kazunobumiyatani/egg52/egg52/ergo50-Edge.Cuts.dxf

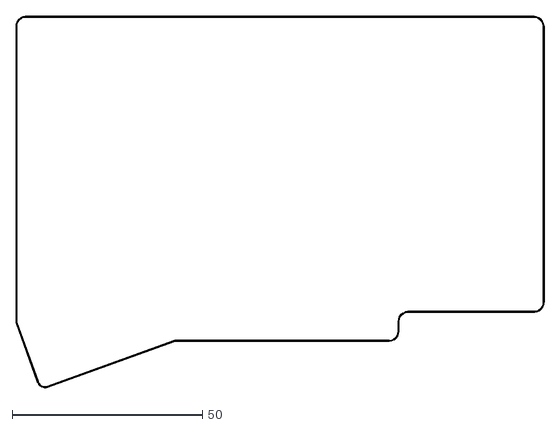
[picture p1: CAD file, 2019-05-01]
egg52/ergo50-Edge.Cuts.dxf
138.6 x 97.5
