kazunobumiyatani/egg52/egg52/ergo50-F.CrtYd.dxf

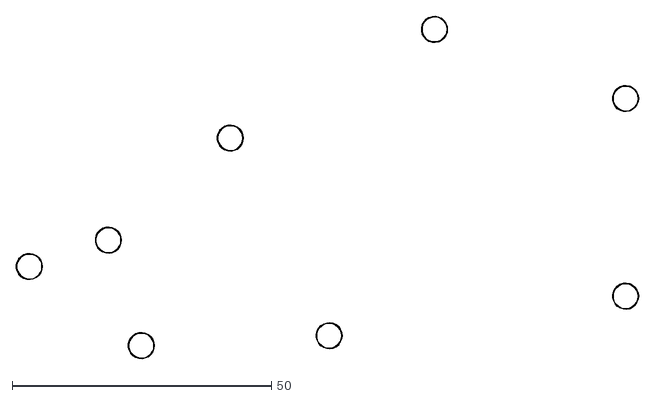
[picture p2: CAD file, 2019-05-01]
egg52/ergo50-F.CrtYd.dxf
119.9 x 65.9
