kazunobumiyatani/egg52/egg52/ergo50-Dwgs.User.dxf

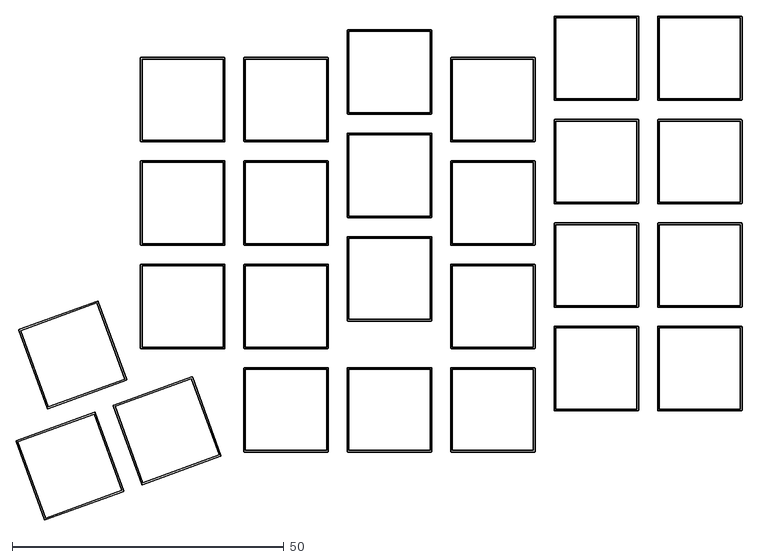
[picture p3: CAD file, 2019-05-01]
egg52/ergo50-Dwgs.User.dxf
133.7 x 92.8
