kazunobumiyatani/egg52/egg52/ergo50.sch

## KiCad design egg52/ergo50.sch (2019-05-01)

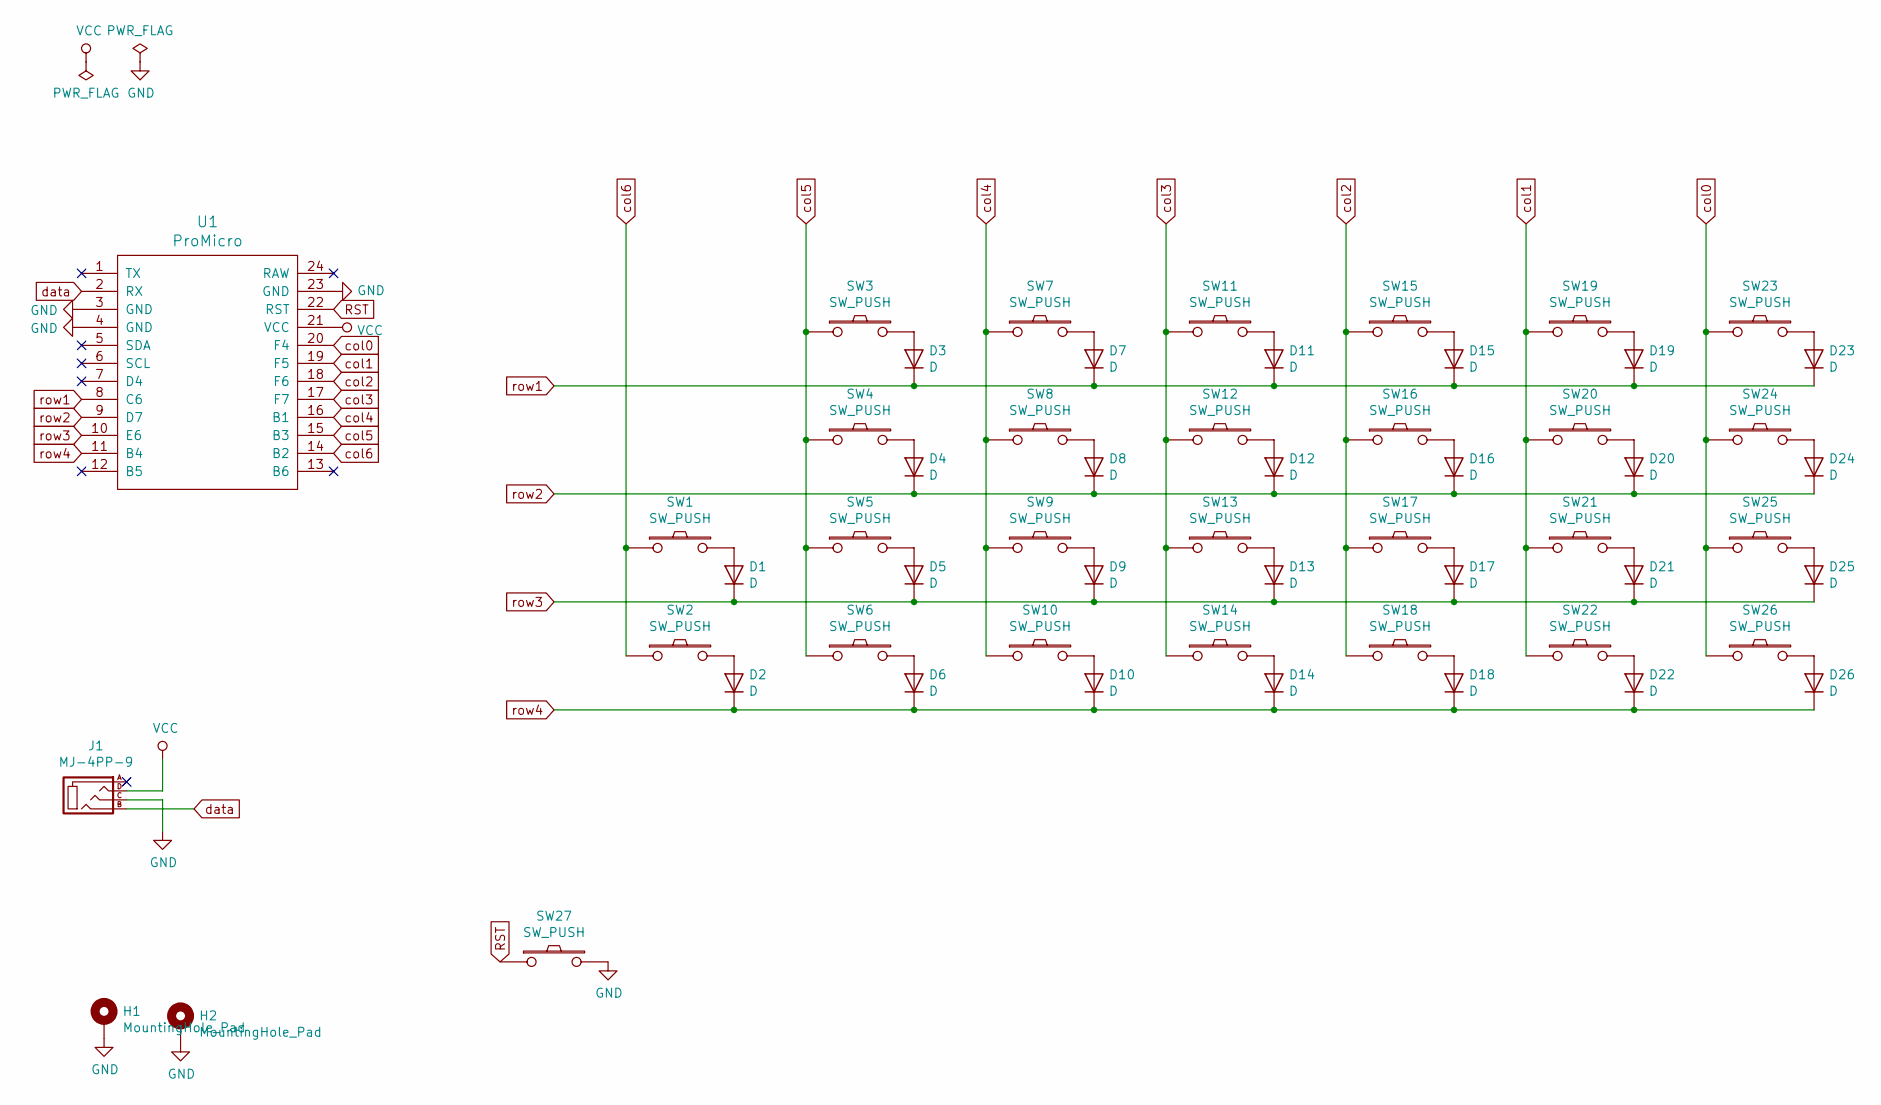
[picture p4: schematic ergo50.sch]

Parts:
D1, D2, D3, D4, D5, D6, D7, D8, D9, D10, D11, D12, D13, D14, D15, D16, D17, D18, D19, D20, D21, D22, D23, D24, D25, D26: D; D3_TH_SMD
H1, H2: MountingHole_Pad; MountingHole_2.2mm_M2_Pad
J1: MJ-4PP-9
SW1, SW2, SW3, SW4, SW5, SW6, SW7, SW8, SW9, SW10, SW11, SW12, SW13, SW14, SW15, SW16, SW17, SW18, SW19, SW20, SW21, SW22, SW23, SW24, SW25, SW26: SW_PUSH; MX_PG1350-Under_FLIP_HOLES_
SW27: SW_PUSH; TACT_SWITCH_TVBP06
U1: ProMicro; ProMicro_v2

Connections:
GND: H1.1, H2.1, J1.C, SW27.2, U1.3 (GND), U1.4 (GND), U1.23 (GND)
unnamed: D1.2 (A), SW1.2
unnamed: D2.2 (A), SW2.2
unnamed: D3.2 (A), SW3.2
unnamed: D4.2 (A), SW4.2
unnamed: D5.2 (A), SW5.2
unnamed: D6.2 (A), SW6.2
unnamed: D7.2 (A), SW7.2
unnamed: D8.2 (A), SW8.2
unnamed: D9.2 (A), SW9.2
unnamed: D10.2 (A), SW10.2
unnamed: D11.2 (A), SW11.2
unnamed: D12.2 (A), SW12.2
unnamed: D13.2 (A), SW13.2
unnamed: D14.2 (A), SW14.2
unnamed: D15.2 (A), SW15.2
unnamed: D16.2 (A), SW16.2
unnamed: D17.2 (A), SW17.2
unnamed: D18.2 (A), SW18.2
unnamed: D19.2 (A), SW19.2
unnamed: D20.2 (A), SW20.2
unnamed: D21.2 (A), SW21.2
unnamed: D22.2 (A), SW22.2
unnamed: D23.2 (A), SW23.2
unnamed: D24.2 (A), SW24.2
unnamed: D25.2 (A), SW25.2
unnamed: D26.2 (A), SW26.2
RST: SW27.1, U1.22 (RST)
VCC: J1.D, U1.21 (VCC)
col0: SW23.1, SW24.1, SW25.1, SW26.1, U1.20 (F4)
col1: SW19.1, SW20.1, SW21.1, SW22.1, U1.19 (F5)
col2: SW15.1, SW16.1, SW17.1, SW18.1, U1.18 (F6)
col3: SW11.1, SW12.1, SW13.1, SW14.1, U1.17 (F7)
col4: SW7.1, SW8.1, SW9.1, SW10.1, U1.16 (B1)
col5: SW3.1, SW4.1, SW5.1, SW6.1, U1.15 (B3)
col6: SW1.1, SW2.1, U1.14 (B2)
data: J1.B, U1.2 (RX)
row1: D3.1 (K), D7.1 (K), D11.1 (K), D15.1 (K), D19.1 (K), D23.1 (K), U1.8 (C6)
row2: D4.1 (K), D8.1 (K), D12.1 (K), D16.1 (K), D20.1 (K), D24.1 (K), U1.9 (D7)
row3: D1.1 (K), D5.1 (K), D9.1 (K), D13.1 (K), D17.1 (K), D21.1 (K), D25.1 (K), U1.10 (E6)
row4: D2.1 (K), D6.1 (K), D10.1 (K), D14.1 (K), D18.1 (K), D22.1 (K), D26.1 (K), U1.11 (B4)
