kazunobumiyatani/egg52/egg52/rescue-backup/ergo50-2019-03-15-19-19-38.sch

## KiCad design egg52/rescue-backup/ergo50-2019-03-15-19-19-38.sch (2019-05-01)

Schematic: ergo50-2019-03-15-19-19-38.sch

Parts:
D1, D2, D3, D4, D5, D6, D7, D8, D9, D10, D11, D12, D13, D14, D15, D16, D17, D18, D19, D20, D21, D22, D23, D24, D25, D26, D27, D28, D29, D30, D31, D32: D; D3_TH_SMD
J1: MJ-4PP-9; MJ-4PP-9_rev2
JP1: JPC2
JP2, JP3: JP2; Jumper
JP4, JP11: GND; Jumper
JP5, JP10: VCC; Jumper
JP6, JP9: SCL; Jumper
JP7, JP8: SDA; Jumper
P1, P2: CONN_01X01; 1PIN_0.1
P3: OLED; MY_SIL-4
P4: LED; StripLED_rev
P5: ICSP; MY_SIL-2x3
R1, R2: R; R2
SW1, SW2, SW3, SW4, SW5, SW6, SW7, SW8, SW9, SW10, SW11, SW12, SW13, SW14, SW15, SW16, SW17, SW18, SW19, SW20, SW21, SW22, SW23, SW24, SW25, SW26, SW27, SW28, SW29, SW30, SW31, SW32: SW_PUSH; MX_ALPS_PG1350_noLed
SW33: Reset; SW_3.5x6.0_TH
U1: ProMicro; ProMicro_rev
U2, U3, U4, U5, U6, U7, U8, U9, U10, U11, U12, U13, U14, U15, U16, U17, U18, U19, U20, U21, U22, U23, U24, U25, U26, U27, U28, U29, U30, U31, U32, U33: SK6812mini; SK6812MINI_rev

Notes on the sheet:
Left Hand Side
Right Hand Side
