kazunobumiyatani/egg52/egg52 Build Guide .odt

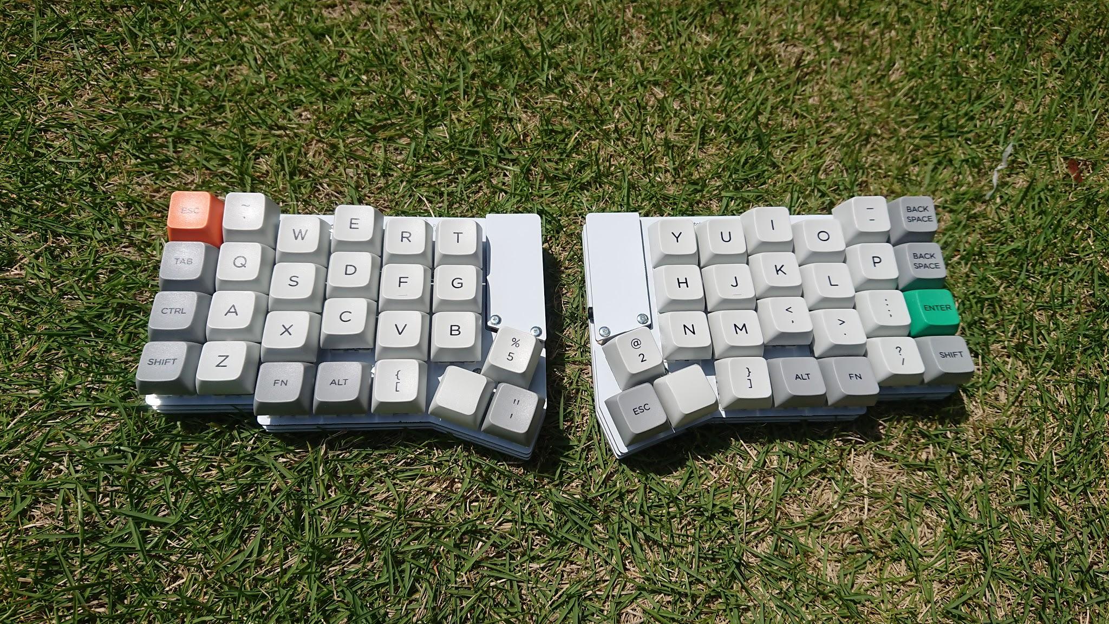
[picture p12: figure]
